KiranMystery/teddy-me/setup.html

# Add an animal

Teach an animal your WiFi and give every animal in your zoo the same code so they can feel each other.

1. Connect to the animal (Bluetooth)

Not connected. The animal must be in setup mode (blue LED off, advertising as “Teddy”).

Animal id: ? ·

WiFi network (2.4 GHz only)

Rescan

Network name WiFi password

Show

Zoo code (same on every animal)

New

2. Send to animal Forget WiFi on this animal

The animal is restarting and joining your WiFi (LED blinks while it connects, then one buzz).

Now open your zoo on this phone. Set up more animals with the same zoo code.
