KiranMystery/teddy-me/(commit log)

2026-11-05 Teddy bear: ESP32 sketch, phone control page, wiring diagram
2026-11-05 C1: note 10–100 µF range
2026-11-05 Add Bluetooth (BLE) version and LED-only schematic
    - teddy_bear_ble: ESP32 BLE sketch, service with motor + led characteristics
    - app-ble.html: Web Bluetooth control page (hold to buzz, light toggle)
    - circuit-led.svg: LED-only wiring for getting started
    - README: BLE instructions, browser support, service UUIDs
    [teddy_bear_ble.ino]
2026-11-05 Add flash.sh for arduino-cli build/upload
2026-11-05 BLE page: use write-with-response where needed; log LED/motor changes on serial
    The light characteristic only allows normal writes, but the page always
    used writeValueWithoutResponse, so light toggles were rejected silently.
2026-11-09 README: motor wiring walkthrough with transistor pinouts
2026-11-09 README: pin-counting guide for 30/38-pin boards, motor troubleshooting
2026-11-11 BLE sketch: slow LED pulse via PWM (LED char: 0 off, 1 pulse, 2 steady)
2026-11-11 README: LED characteristic values
2026-11-11 Zoo: animals with owners, filters, per-animal paw/light/links; paw button on GPIO 27 triggers linked animals; WiFi scan picker in setup
2026-11-11 Setup: show/hide password; firmware logs WiFi failure reason, retries saved WiFi every minute
    [teddy_link.ino]
